DukeAdam/Kevin/Images/IMG_20180503_180507.jpg

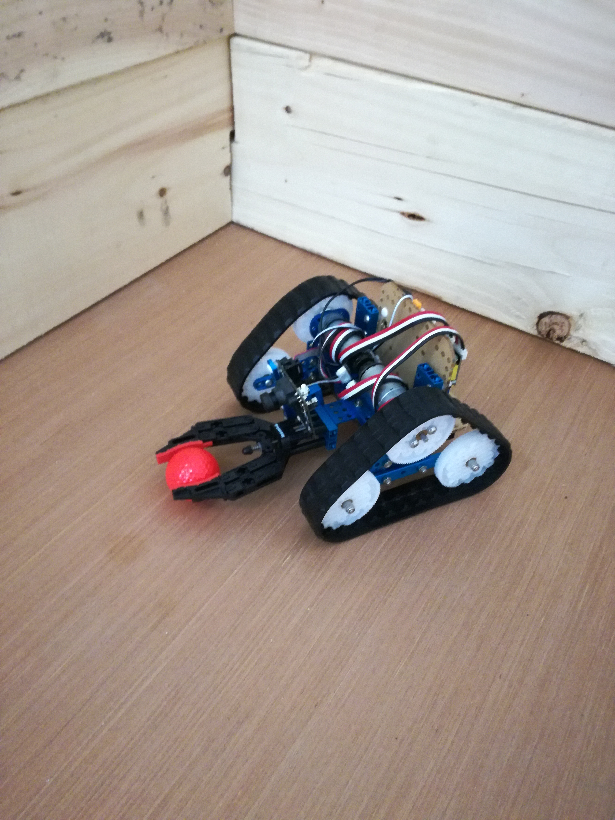
Images/IMG_20180503_180507.jpg
