DukeAdam/Kevin/Images/IMG_20180306_131905.jpg

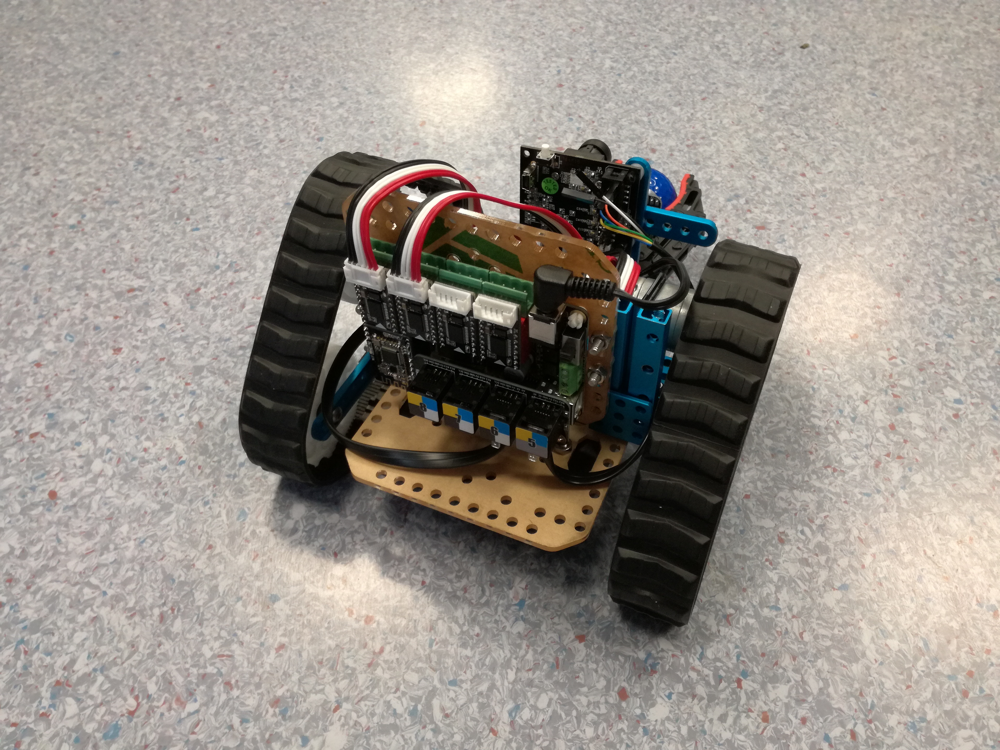
Images/IMG_20180306_131905.jpg
