DukeAdam/Kevin/Algorithm/README.md

The algorithm we implemented into our code, represented by a flow chart
