DukeAdam/Kevin/Algorithm/Find Ball code.pdf

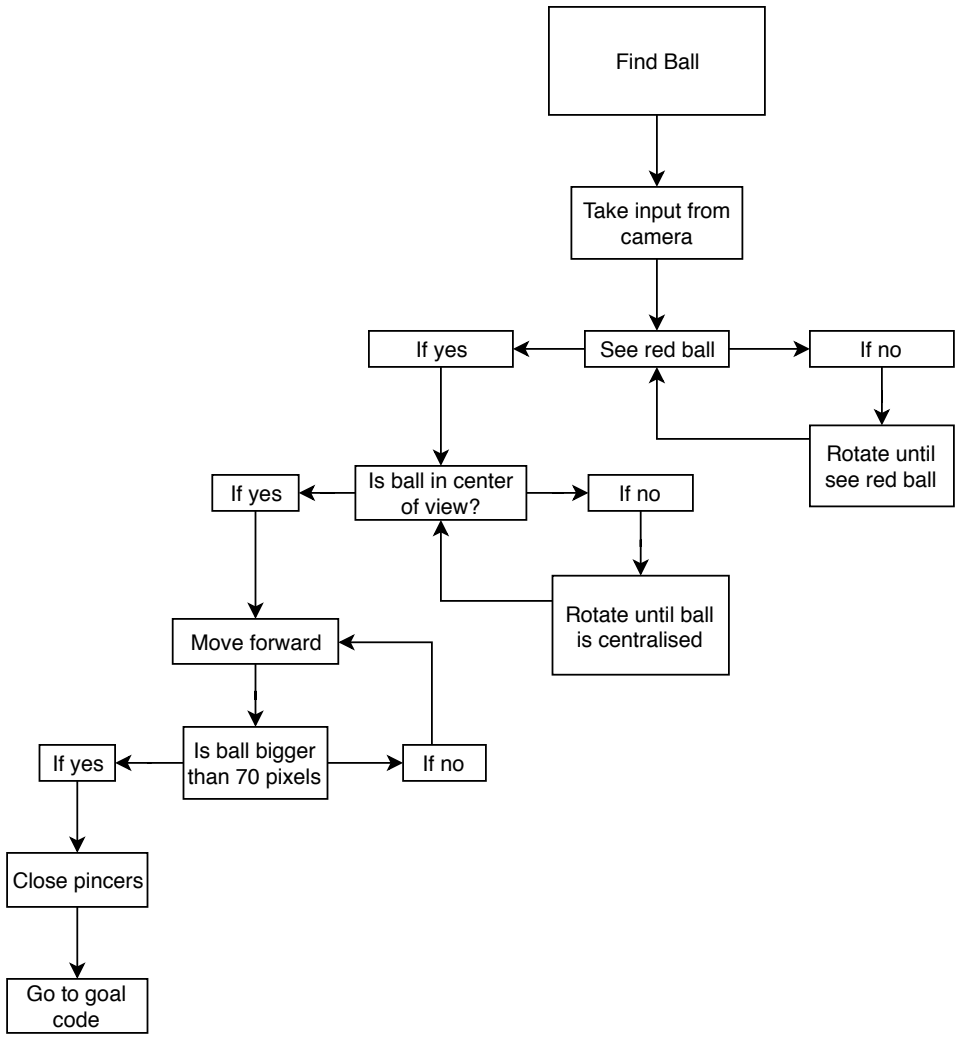
[picture p21: figure]
Find Ball; Take input from camera; If yes; See red ball; Is ball in center; of view? If yes; Move forward; Rotate until ball is centralised; Rotate until see red ball; Is ball bigger; than 70 pixels If yes; Close pincers; Go to goal code
