DukeAdam/Kevin/Algorithm/Go to Goal code.pdf

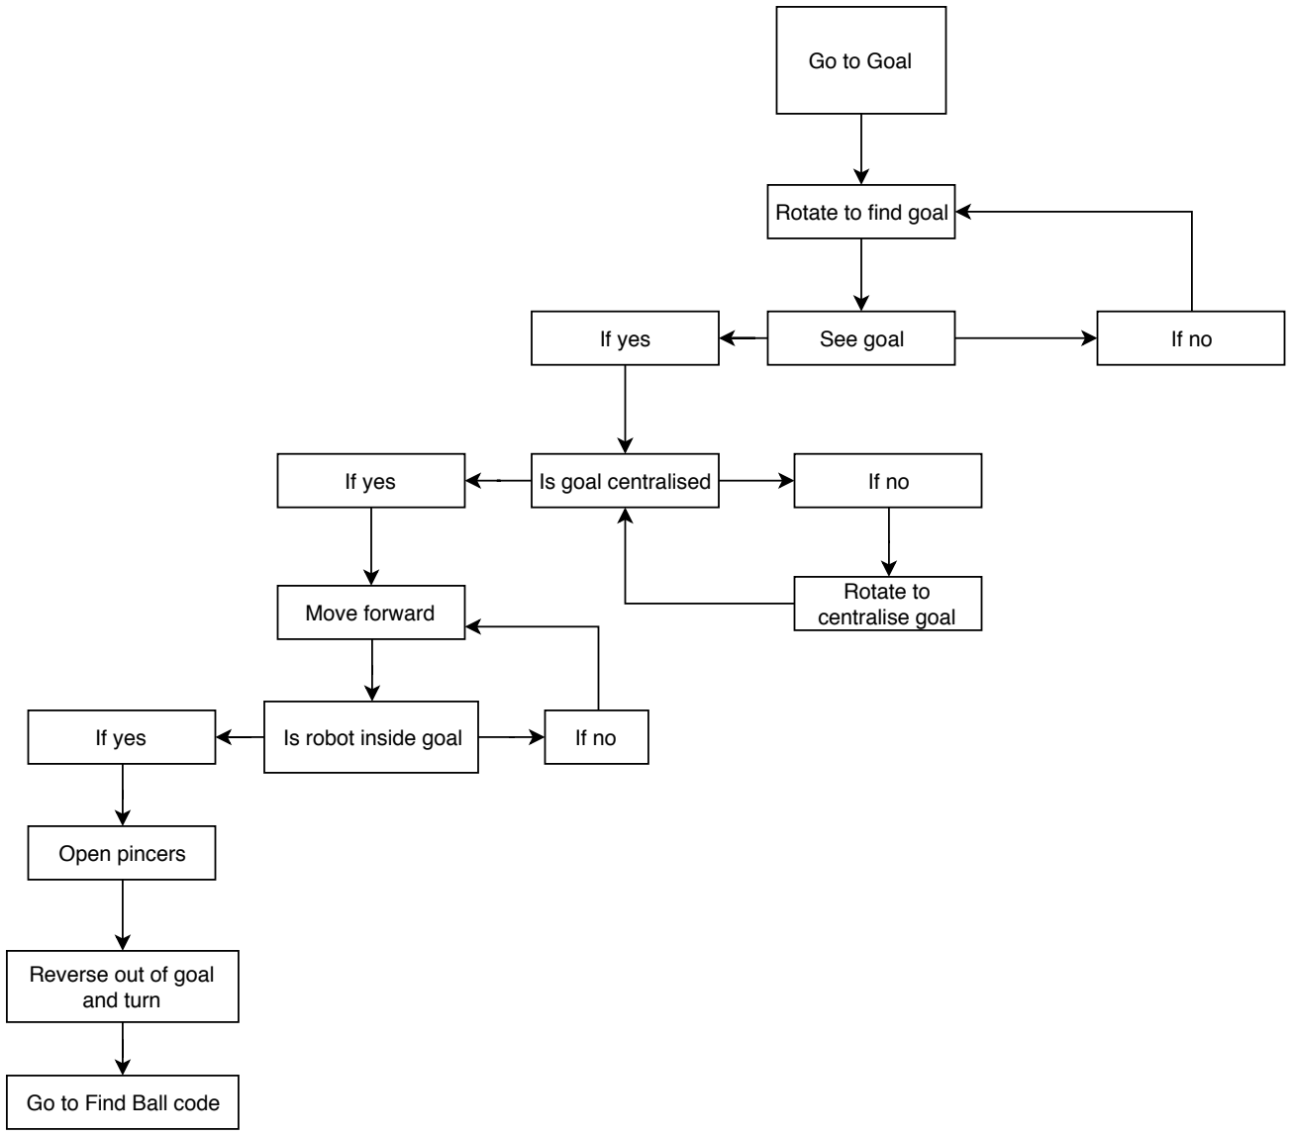
[picture p22: figure]
Go to Goal; Rotate to find goal; If yes; See goal; Is goal centralised; Rotate to centralise goal; Move forward; Is robot inside goal; Open pincers; Reverse out of goal and turn; Go to Find Ball code
