DukeAdam/Kevin/Images/Capture.JPG

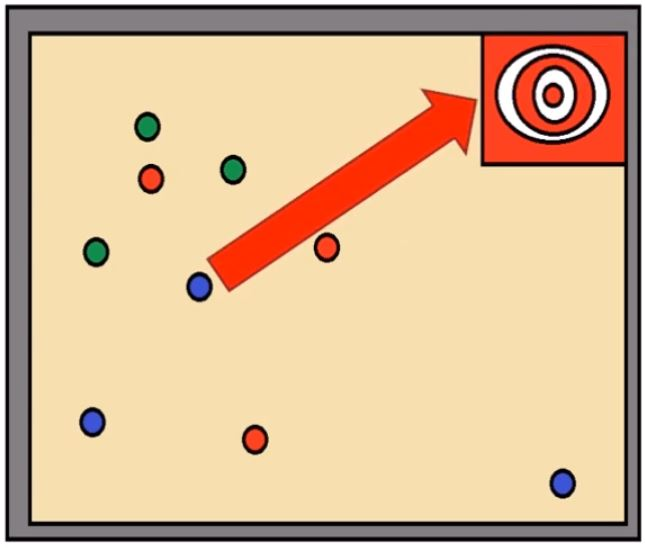
Images/Capture.JPG
