DukeAdam/Kevin/Images/IMG_20180227_124740.jpg

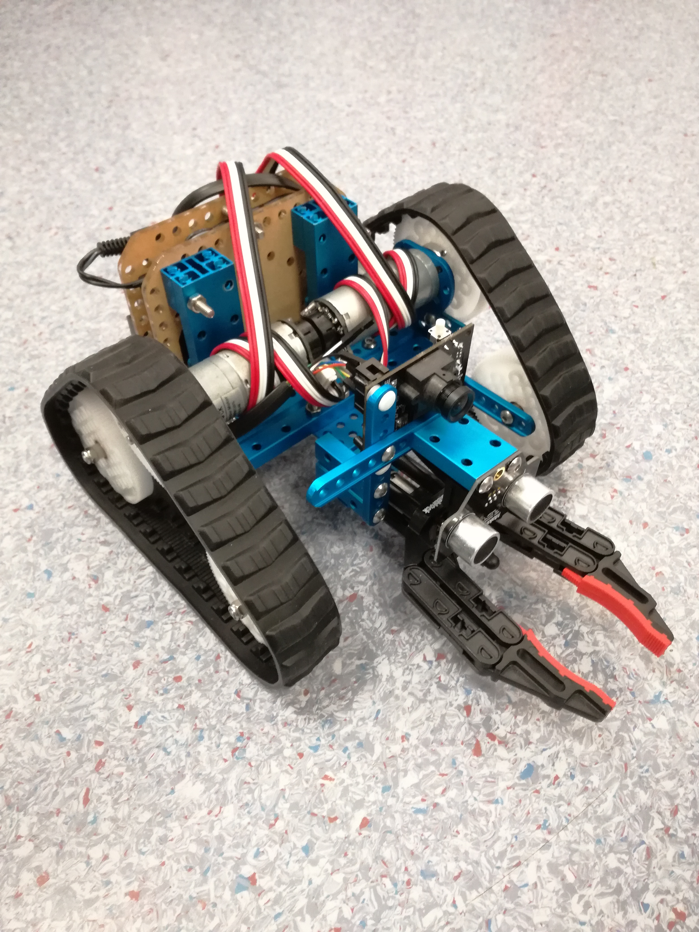
Images/IMG_20180227_124740.jpg
